xyzz/poverty-alice/production/fr4-plate/notes.txt

Please place factory code on the back of the pcb; this pcb has no drill holes; please cover both sides with soldermask completely
