xyzz/poverty-alice/production/fr4-mid/note.txt

both sides fully covered with solder mask; no drill holes
