xyzz/poverty-alice/vector/alice-top-piece.dxf

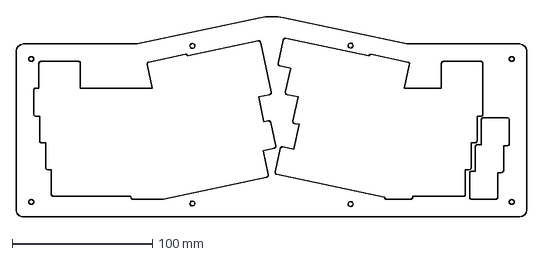
[picture p1: CAD file, 2020-06-27]
vector/alice-top-piece.dxf
364.2 x 143.2 mm
