xyzz/poverty-alice/vector/alice-plate.dxf

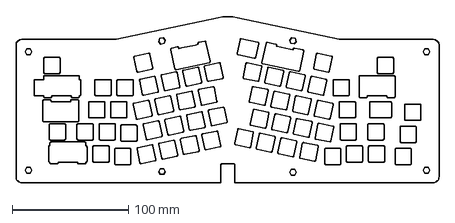
[picture p2: CAD file, 2020-06-27]
vector/alice-plate.dxf
364.2 x 143.2 mm
