xyzz/poverty-alice/vector/alice-bottom-piece.dxf

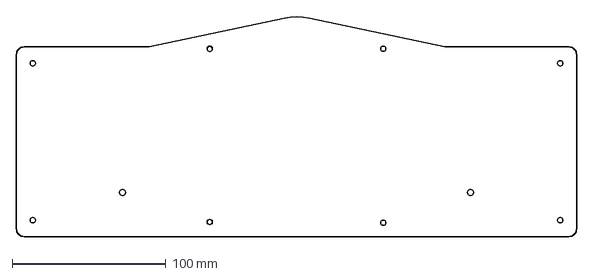
[picture p3: CAD file, 2020-06-27]
vector/alice-bottom-piece.dxf
364.2 x 143.2 mm
