xyzz/poverty-alice/vector/alice-mid-piece.dxf

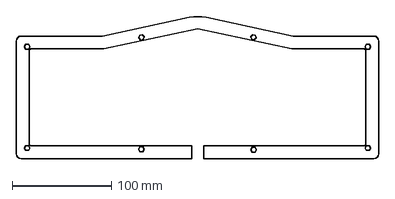
[picture p4: CAD file, 2020-06-27]
vector/alice-mid-piece.dxf
364.2 x 143.2 mm
