xyzz/poverty-alice/pcb/keyboard.kicad_pcb

## KiCad design pcb/keyboard.kicad_pcb (2020-06-27)

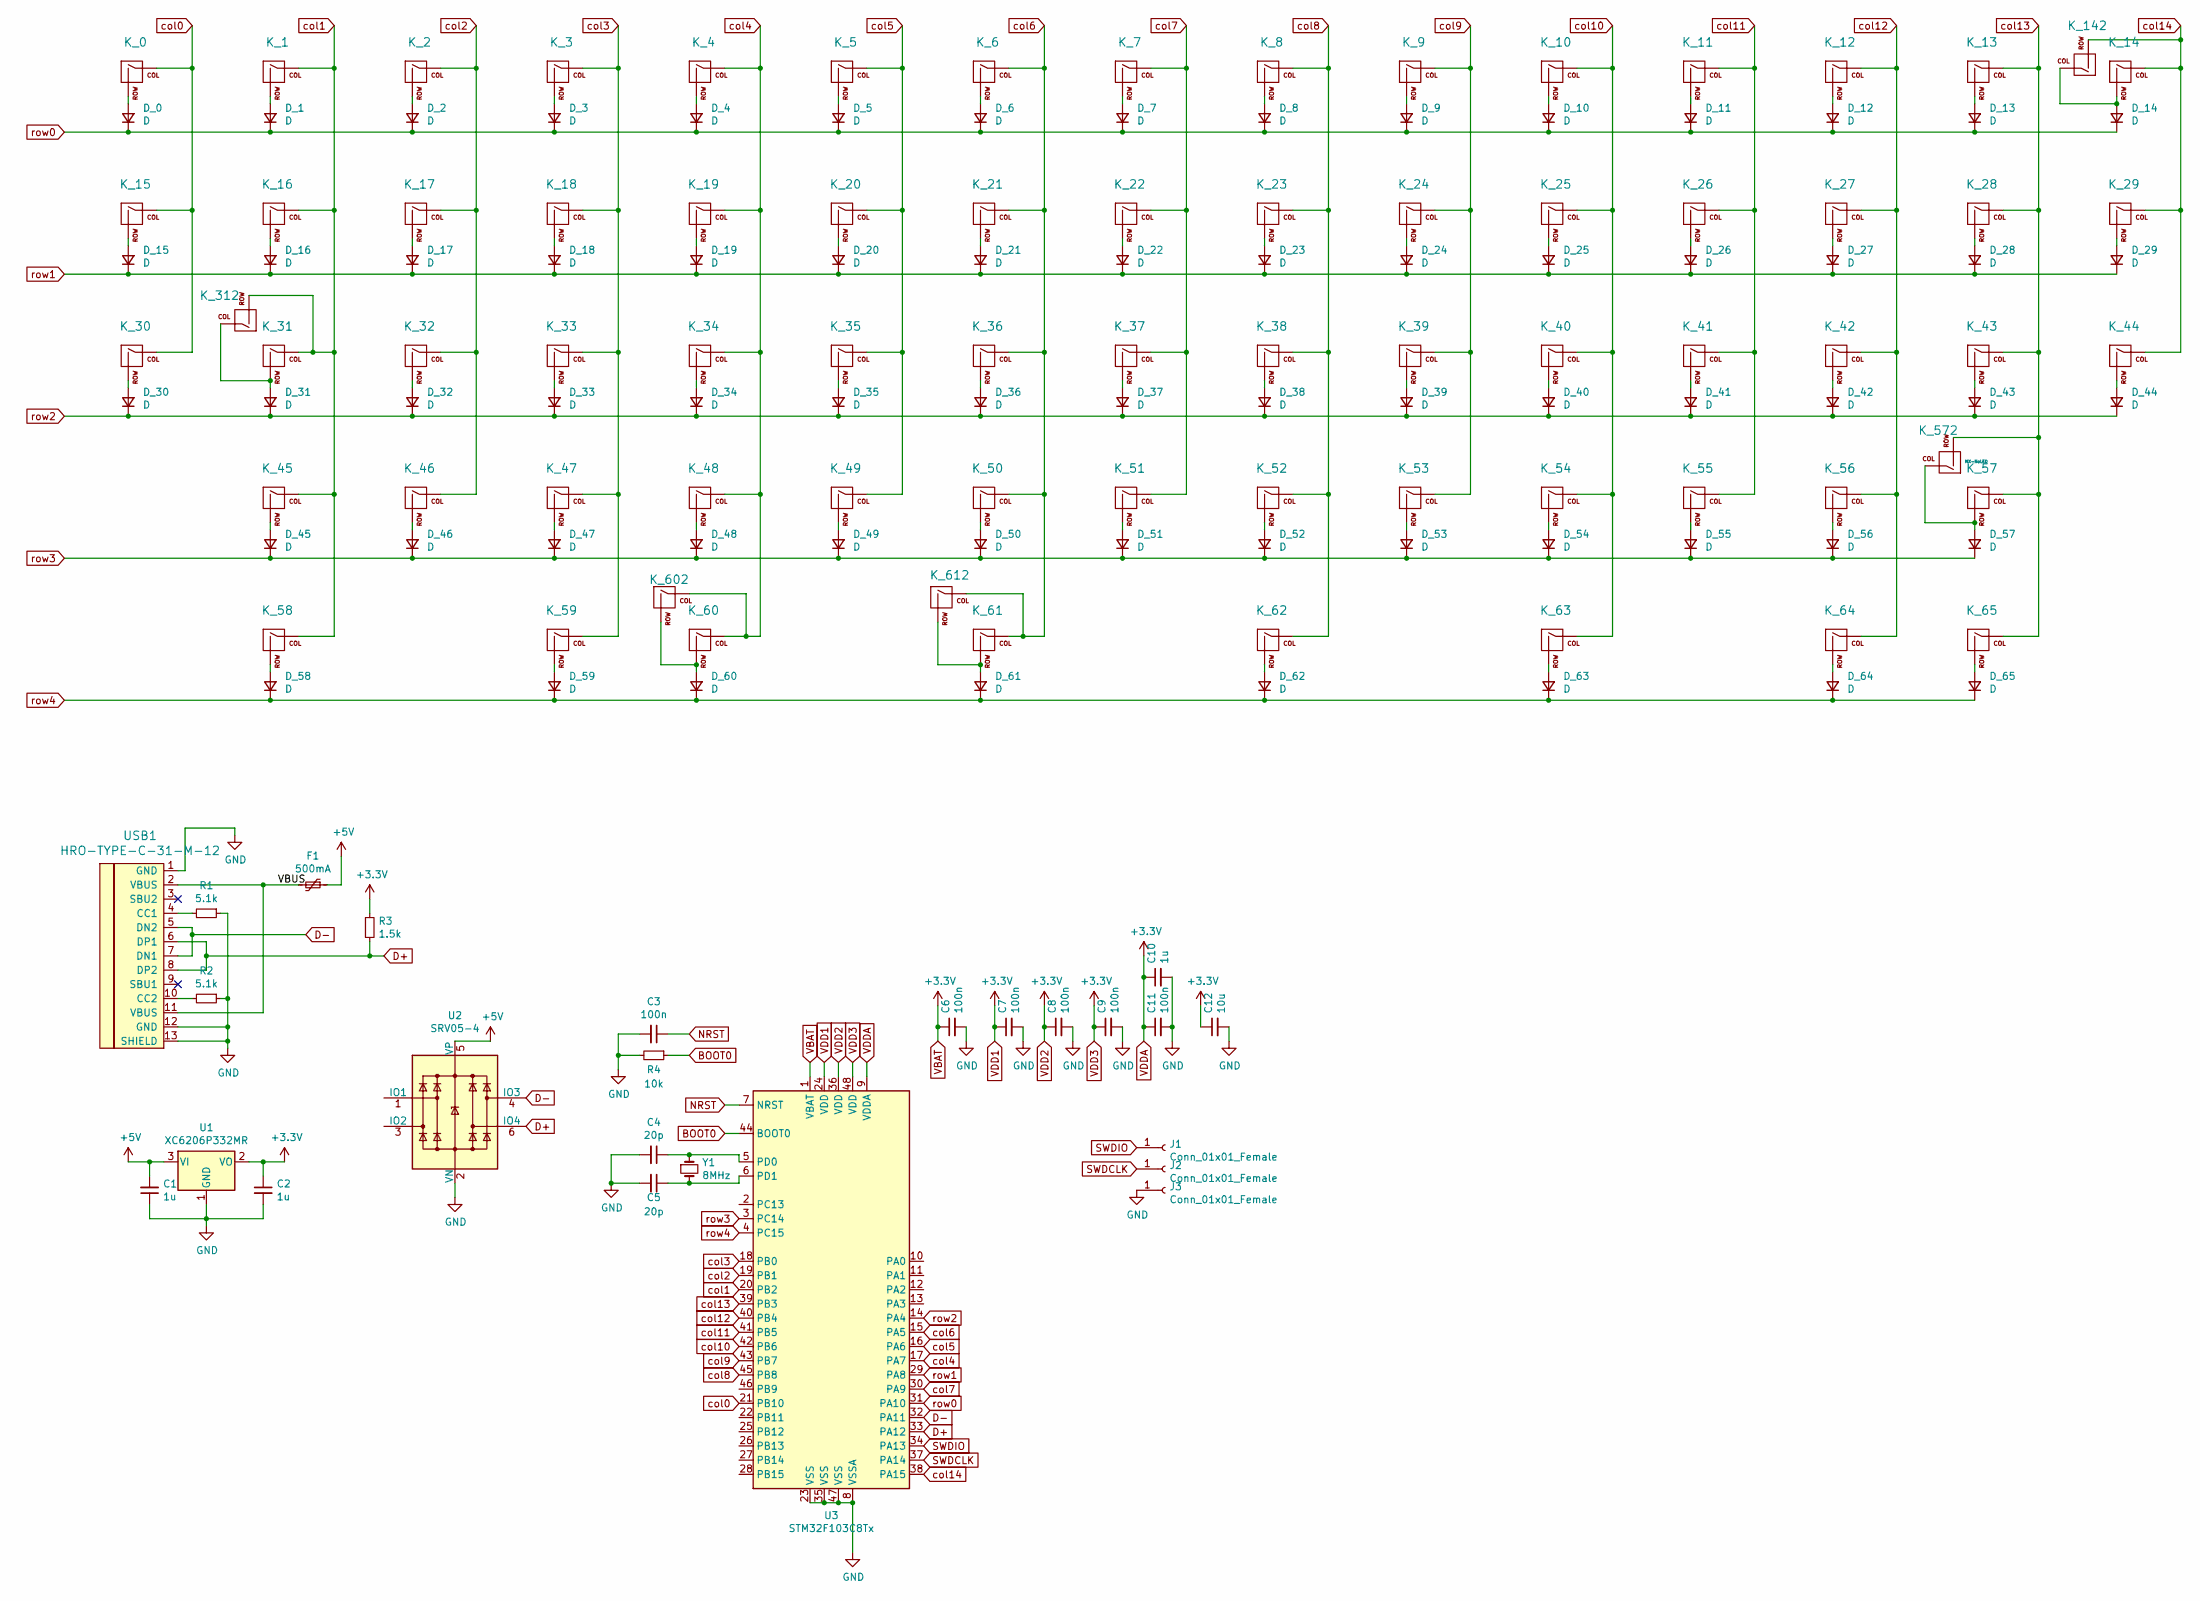
[picture p5: schematic keyboard.sch]

Parts:
C1, C2, C10: 1u; C_0603_1608Metric; JLC C15849
C3, C6, C7, C8, C9, C11: 100n; C_0603_1608Metric; JLC C14663
C4, C5: 20p; C_0603_1608Metric; JLC C1648
C12: 10u; C_0603_1608Metric; JLC C19702
D_0, D_1, D_2, D_3, D_4, D_5, D_6, D_7, D_8, D_9, D_10, D_11, D_12, D_13, D_14, D_15, D_16, D_17, D_18, D_19, D_20, D_21, D_22, D_23, D_24, D_25, D_26, D_27, D_28, D_29, D_30, D_31, D_32, D_33, D_34, D_35, D_36, D_37, D_38, D_39, D_40, D_41, D_42, D_43, D_44, D_45, D_46, D_47, D_48, D_49, D_50, D_51, D_52, D_53, D_54, D_55, D_56, D_57, D_58, D_59, D_60, D_61, D_62, D_63, D_64, D_65: D; D_SOD-123; JLC C64898
F1: 500mA; Fuse_1206_3216Metric; JLC C369159
J1, J2, J3: Conn_01x01_Female; TestPoint_Pad_D1.5mm
K_0, K_1, K_2, K_3, K_4, K_5, K_6, K_7, K_8, K_9, K_10, K_11, K_12, K_13, K_14, K_15, K_17, K_18, K_19, K_20, K_21, K_22, K_23, K_24, K_25, K_26, K_27, K_28, K_29, K_30, K_32, K_33, K_34, K_35, K_36, K_37, K_38, K_39, K_40, K_41, K_42, K_46, K_47, K_48, K_49, K_50, K_51, K_52, K_53, K_54, K_55, K_56, K_65: KEYSW; MXOnly-1U-NoLED
K_16, K_44, K_58, K_59, K_63, K_64: KEYSW; MXOnly-1.5U-NoLED
K_31, K_57: KEYSW; MXOnly-1.75U-NoLED
K_43: KEYSW; MXOnly-2.25U-ReversedStabilizers-NoLED
K_45: KEYSW; MXOnly-2.25U-NoLED
K_60: KEYSW; MXOnly-2U-ReversedStabilizers-NoLED
K_61: KEYSW; MXOnly-1.25U-NoLED
K_62: KEYSW; MXOnly-2.75U-ReversedStabilizers-NoLED
K_142: MX-NoLED; MXOnly-2U-NoLED
K_312, K_612: MX-NoLED; MXOnly-1U-NoLED
K_572: MX-NoLED; MXOnly-2.75U-NoLED
K_602: MX-NoLED; MXOnly-2.25U-ReversedStabilizers-NoLED
R1, R2: 5.1k; R_0603_1608Metric; JLC C23186
R3: 1.5k; R_0603_1608Metric; JLC C22843
R4: 10k; R_0603_1608Metric; JLC C25804
U1: XC6206P332MR; SOT-23; JLC C5446
U2: SRV05-4; SOT-23-6; JLC C85364
U3: STM32F103C8Tx; LQFP-48_7x7mm_P0.5mm; JLC C8734
USB1: HRO-TYPE-C-31-M-12; HRO-TYPE-C-31-M-12-jlc
Y1: 8MHz; Crystal_SMD_5032-2Pin_5.0x3.2mm; JLC C115962

Connections:
+5V: C1.2, F1.1, U1.3 (VI), U2.5 (VP)
/VBUS: F1.2, USB1.2 (VBUS), USB1.11 (VBUS)
BOOT0: R4.1, U3.44 (BOOT0)
D+: R3.2, U2.6 (IO4), U3.33 (PA12), USB1.6 (DP1), USB1.8 (DP2)
D-: U2.4 (IO3), U3.32 (PA11), USB1.5 (DN2), USB1.7 (DN1)
GND: C1.1, C2.2, C3.2, C4.2, C5.2, C6.2, C7.2, C8.2, C9.2, C10.2, C11.2, C12.2, J3.1, R1.1, R2.1, R4.2, U1.1 (GND), U2.2 (VN), U3.8 (VSSA), U3.23 (VSS), U3.35 (VSS), U3.47 (VSS), USB1.1 (GND), USB1.12 (GND), USB1.13 (SHIELD)
NRST: C3.1, U3.7 (NRST)
unnamed: C4.1, U3.5 (PD0), Y1.1
unnamed: C5.1, U3.6 (PD1), Y1.2
unnamed: D_0.2 (A), K_0.2 (ROW)
unnamed: D_1.2 (A), K_1.2 (ROW)
unnamed: D_2.2 (A), K_2.2 (ROW)
unnamed: D_3.2 (A), K_3.2 (ROW)
unnamed: D_4.2 (A), K_4.2 (ROW)
unnamed: D_5.2 (A), K_5.2 (ROW)
unnamed: D_6.2 (A), K_6.2 (ROW)
unnamed: D_7.2 (A), K_7.2 (ROW)
unnamed: D_8.2 (A), K_8.2 (ROW)
unnamed: D_9.2 (A), K_9.2 (ROW)
unnamed: D_10.2 (A), K_10.2 (ROW)
unnamed: D_11.2 (A), K_11.2 (ROW)
unnamed: D_12.2 (A), K_12.2 (ROW)
unnamed: D_13.2 (A), K_13.2 (ROW)
unnamed: D_14.2 (A), K_14.2 (ROW), K_142.1 (COL)
unnamed: D_15.2 (A), K_15.2 (ROW)
unnamed: D_16.2 (A), K_16.2 (ROW)
unnamed: D_17.2 (A), K_17.2 (ROW)
unnamed: D_18.2 (A), K_18.2 (ROW)
unnamed: D_19.2 (A), K_19.2 (ROW)
unnamed: D_20.2 (A), K_20.2 (ROW)
unnamed: D_21.2 (A), K_21.2 (ROW)
unnamed: D_22.2 (A), K_22.2 (ROW)
unnamed: D_23.2 (A), K_23.2 (ROW)
unnamed: D_24.2 (A), K_24.2 (ROW)
unnamed: D_25.2 (A), K_25.2 (ROW)
unnamed: D_26.2 (A), K_26.2 (ROW)
unnamed: D_27.2 (A), K_27.2 (ROW)
unnamed: D_28.2 (A), K_28.2 (ROW)
unnamed: D_29.2 (A), K_29.2 (ROW)
unnamed: D_30.2 (A), K_30.2 (ROW)
unnamed: D_31.2 (A), K_31.2 (ROW), K_312.1 (COL)
unnamed: D_32.2 (A), K_32.2 (ROW)
unnamed: D_33.2 (A), K_33.2 (ROW)
unnamed: D_34.2 (A), K_34.2 (ROW)
unnamed: D_35.2 (A), K_35.2 (ROW)
unnamed: D_36.2 (A), K_36.2 (ROW)
unnamed: D_37.2 (A), K_37.2 (ROW)
unnamed: D_38.2 (A), K_38.2 (ROW)
unnamed: D_39.2 (A), K_39.2 (ROW)
unnamed: D_40.2 (A), K_40.2 (ROW)
unnamed: D_41.2 (A), K_41.2 (ROW)
unnamed: D_42.2 (A), K_42.2 (ROW)
unnamed: D_43.2 (A), K_43.2 (ROW)
unnamed: D_44.2 (A), K_44.2 (ROW)
unnamed: D_45.2 (A), K_45.2 (ROW)
unnamed: D_46.2 (A), K_46.2 (ROW)
unnamed: D_47.2 (A), K_47.2 (ROW)
unnamed: D_48.2 (A), K_48.2 (ROW)
unnamed: D_49.2 (A), K_49.2 (ROW)
unnamed: D_50.2 (A), K_50.2 (ROW)
unnamed: D_51.2 (A), K_51.2 (ROW)
unnamed: D_52.2 (A), K_52.2 (ROW)
unnamed: D_53.2 (A), K_53.2 (ROW)
unnamed: D_54.2 (A), K_54.2 (ROW)
unnamed: D_55.2 (A), K_55.2 (ROW)
unnamed: D_56.2 (A), K_56.2 (ROW)
unnamed: D_57.2 (A), K_57.2 (ROW), K_572.1 (COL)
unnamed: D_58.2 (A), K_58.2 (ROW)
unnamed: D_59.2 (A), K_59.2 (ROW)
unnamed: D_60.2 (A), K_60.2 (ROW), K_602.2 (ROW)
unnamed: D_61.2 (A), K_61.2 (ROW), K_612.2 (ROW)
unnamed: D_62.2 (A), K_62.2 (ROW)
unnamed: D_63.2 (A), K_63.2 (ROW)
unnamed: D_64.2 (A), K_64.2 (ROW)
unnamed: D_65.2 (A), K_65.2 (ROW)
unnamed: R1.2, USB1.4 (CC1)
unnamed: R2.2, USB1.10 (CC2)
SWDCLK: J2.1, U3.37 (PA14)
SWDIO: J1.1, U3.34 (PA13)
VBAT: C2.1, C6.1, C7.1, C8.1, C9.1, C10.1, C11.1, C12.1, R3.1, U1.2 (VO), U3.1 (VBAT), U3.9 (VDDA), U3.24 (VDD), U3.36 (VDD), U3.48 (VDD)
col0: K_0.1 (COL), K_15.1 (COL), K_30.1 (COL), U3.21 (PB10)
col1: K_1.1 (COL), K_16.1 (COL), K_31.1 (COL), K_45.1 (COL), K_58.1 (COL), K_312.2 (ROW), U3.20 (PB2)
col2: K_2.1 (COL), K_17.1 (COL), K_32.1 (COL), K_46.1 (COL), U3.19 (PB1)
col3: K_3.1 (COL), K_18.1 (COL), K_33.1 (COL), K_47.1 (COL), K_59.1 (COL), U3.18 (PB0)
col4: K_4.1 (COL), K_19.1 (COL), K_34.1 (COL), K_48.1 (COL), K_60.1 (COL), K_602.1 (COL), U3.17 (PA7)
col5: K_5.1 (COL), K_20.1 (COL), K_35.1 (COL), K_49.1 (COL), U3.16 (PA6)
col6: K_6.1 (COL), K_21.1 (COL), K_36.1 (COL), K_50.1 (COL), K_61.1 (COL), K_612.1 (COL), U3.15 (PA5)
col7: K_7.1 (COL), K_22.1 (COL), K_37.1 (COL), K_51.1 (COL), U3.30 (PA9)
col8: K_8.1 (COL), K_23.1 (COL), K_38.1 (COL), K_52.1 (COL), K_62.1 (COL), U3.45 (PB8)
col9: K_9.1 (COL), K_24.1 (COL), K_39.1 (COL), K_53.1 (COL), U3.43 (PB7)
col10: K_10.1 (COL), K_25.1 (COL), K_40.1 (COL), K_54.1 (COL), K_63.1 (COL), U3.42 (PB6)
col11: K_11.1 (COL), K_26.1 (COL), K_41.1 (COL), K_55.1 (COL), U3.41 (PB5)
col12: K_12.1 (COL), K_27.1 (COL), K_42.1 (COL), K_56.1 (COL), K_64.1 (COL), U3.40 (PB4)
col13: K_13.1 (COL), K_28.1 (COL), K_43.1 (COL), K_57.1 (COL), K_65.1 (COL), K_572.2 (ROW), U3.39 (PB3)
col14: K_14.1 (COL), K_29.1 (COL), K_44.1 (COL), K_142.2 (ROW), U3.38 (PA15)
row0: D_0.1 (K), D_1.1 (K), D_2.1 (K), D_3.1 (K), D_4.1 (K), D_5.1 (K), D_6.1 (K), D_7.1 (K), D_8.1 (K), D_9.1 (K), D_10.1 (K), D_11.1 (K), D_12.1 (K), D_13.1 (K), D_14.1 (K), U3.31 (PA10)
row1: D_15.1 (K), D_16.1 (K), D_17.1 (K), D_18.1 (K), D_19.1 (K), D_20.1 (K), D_21.1 (K), D_22.1 (K), D_23.1 (K), D_24.1 (K), D_25.1 (K), D_26.1 (K), D_27.1 (K), D_28.1 (K), D_29.1 (K), U3.29 (PA8)
row2: D_30.1 (K), D_31.1 (K), D_32.1 (K), D_33.1 (K), D_34.1 (K), D_35.1 (K), D_36.1 (K), D_37.1 (K), D_38.1 (K), D_39.1 (K), D_40.1 (K), D_41.1 (K), D_42.1 (K), D_43.1 (K), D_44.1 (K), U3.14 (PA4)
row3: D_45.1 (K), D_46.1 (K), D_47.1 (K), D_48.1 (K), D_49.1 (K), D_50.1 (K), D_51.1 (K), D_52.1 (K), D_53.1 (K), D_54.1 (K), D_55.1 (K), D_56.1 (K), D_57.1 (K), U3.3 (PC14)
row4: D_58.1 (K), D_59.1 (K), D_60.1 (K), D_61.1 (K), D_62.1 (K), D_63.1 (K), D_64.1 (K), D_65.1 (K), U3.4 (PC15)

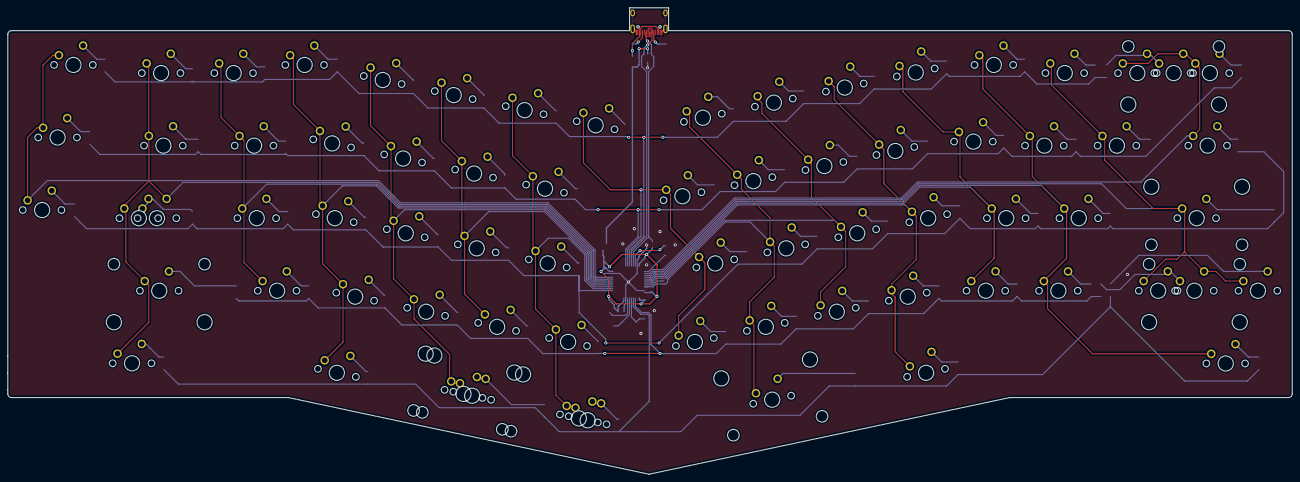
[picture p6: board keyboard.kicad_pcb from above]

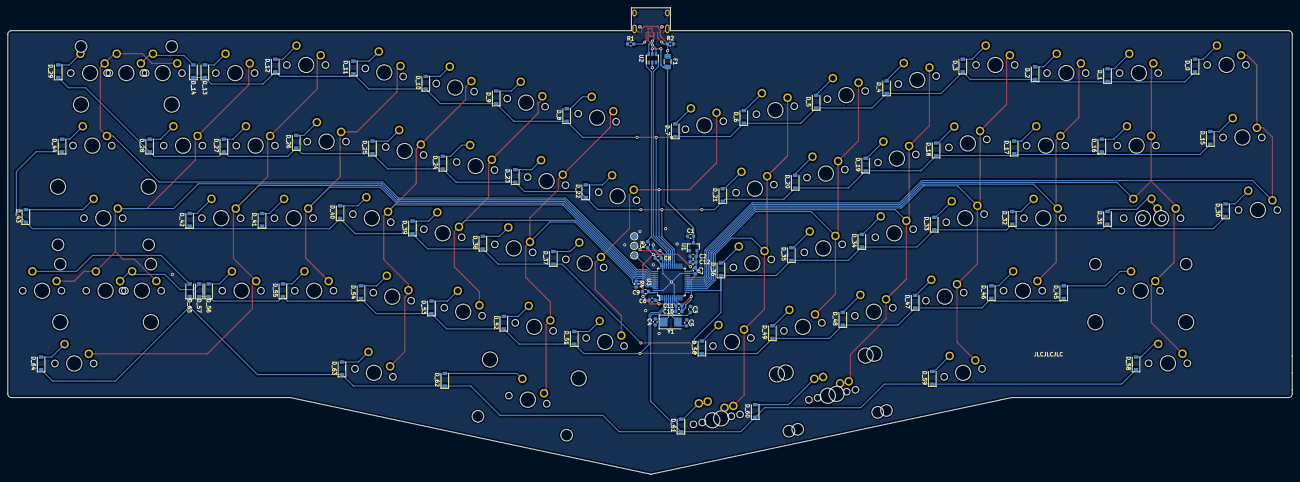
[picture p7: board keyboard.kicad_pcb from below]

Board: 2 copper layers, 337.2 x 122.5 mm, 162 parts (90 on the bottom side), 100 nets.
