xyzz/poverty-alice/(threads)

Thread 1 (2020-11-04):

Prototype

aerovero, 2020-11-04:
Hi, I came across this while looking up open source alice PCBs, and wanted to ask if the PCB and case had been prototyped yet?
I'd love to have an easier way to chat about this project if you're open to it, it looks quite complete at first glance!
